lyusupov/Argus/system/README.md

<h4>Sub-directories content:</h4>

OpenWrt - pre-built binary files of system software for processing module;<br>
Arduino - pre-built binary file(s) of firmware for USB LED display.<br>
