lyusupov/Argus/src/README.md

<h4>Sub-directories content:</h4>

core, drivers, init, lib - source code of application software for processing module;<br>
sketchbook               - Arduino API conformant source code of USB LED display firmware.<br>
