lyusupov/Argus/system/Arduino/README.md

<h4>Sub-directories content:</h4>

ColorduinoSlave   - pre-built binary file(s) of "framebuffer" firmware for Colorduino v1.3 board manufactured by ITEAD Studio;<br>
RainbowduinoSlave - pre-built binary file(s) of "framebuffer" firmware for Rainbowduino v3.0 board manufactured by Seeed Studio.<br>

Binary firmware files can be uploaded into these devices with assistance of AVRDUDE utility.<br>
This utility is available both for Windows and Linux.
