lyusupov/Argus/src/sketchbook/README.md

<h4>Sub-directories content:</h4>

ColorduinoSlave   - source code of "framebuffer" firmware for Colorduino v1.3 board manufactured by ITEAD Studio;<br>
RainbowduinoSlave - source code of "framebuffer" firmware for Rainbowduino v3.0 board manufactured by Seeed Studio.<br>
