lyusupov/Argus/system/OpenWrt/TL-WR703N/README.md

<h4>Filelist:</h4>

argus-tl-wr703n-firmware-0.9.bin   - pre-built binary file(s) of firmware for TP-Link TL-WR703N router;<br>

Router's binary firmware files can be uploaded into these devices with assistance of a Web browser.<br>
Follow the instructions provided by manufacturer of this router.<br>

CAUTION! argus-tl-wr703n-firmware-0.9.bin is based on OpenWrt Attitude Adjustment 12.09-rc1.<br>
If your router's factory firmware version is V1.7 flashing it with AA 12.09-rc1 will likely brick your router!<br>
For details, please, read this: http://wiki.openwrt.org/toh/tp-link/tl-wr703n?s%5B%5D=wr703n#warnings.gotchas <br>
