lyusupov/Argus/(commit log)

2013-11-14 Misc. update of prototype section.
2013-11-23 Misc. update of Prototype and Tests sections
2013-12-01 Firmware files for LED controllers. Ready-to-flash images. Use them with AVRdude.
2013-12-08 README.md in Arduino subdirectory is created.
2013-12-08 README.md in Arduino subdirectory is updated.
